EngrErics/LBTiny-FPGA/docs/diagram-links.md

Draw.IO
https://drive.google.com/file/d/1SJZEqH65o_Fi_vQxV7Hg5AI4URk4NXu5/view?usp=sharing

TinyTapeout Breakout PCB
https://github.com/TinyTapeout/breakout-pcb
https://github.com/psychogenic/tinytapeout-kicad-libs/tree/c213eb9e5d98a454f17367063bc4ec78d6119a49
