EngrErics/LBTiny-FPGA/src/lbtiny.xdc

## =========================================================================
## lbtiny.xdc
## Nexys A7-100T constraints for lbtiny_top (production integrated build).
## Target part: xc7a100tcsg324-1. Also works on -50T.
##
## Covers: clock, SW[15:0], BTNC, BTNU, LED[15:0], 7-seg,
##         Pmod JA (STM32 bus control + upper address),
##         Pmod JB (multiplexed address/data, bidirectional).
##
## SW[15]: CPU halt / viewer mutation enable.
##   UP   -> cpu_reset_n asserted, viewer BTNC/BTNU active.
##   DOWN -> CPU running, observation live, mutation blocked.
##
## LED[15]: CPU halted indicator (lit when SW15 up or STM32 holds RESET_n low).
## =========================================================================

## Clock: 100 MHz on-board oscillator
set_property -dict { PACKAGE_PIN E3 IOSTANDARD LVCMOS33 } [get_ports { CLK100MHZ }]
create_clock -add -name sys_clk_pin -period 10.00 -waveform {0 5} [get_ports { CLK100MHZ }]

## -------------------------------------------------------------------------
## Switches SW[15:0]
##   SW[11:0]  address select for viewer
##   SW[15]    CPU halt / mutation enable
##   SW[14:12] unused
## -------------------------------------------------------------------------
set_property -dict { PACKAGE_PIN J15 IOSTANDARD LVCMOS33 } [get_ports { SW[0]  }]
set_property -dict { PACKAGE_PIN L16 IOSTANDARD LVCMOS33 } [get_ports { SW[1]  }]
set_property -dict { PACKAGE_PIN M13 IOSTANDARD LVCMOS33 } [get_ports { SW[2]  }]
set_property -dict { PACKAGE_PIN R15 IOSTANDARD LVCMOS33 } [get_ports { SW[3]  }]
set_property -dict { PACKAGE_PIN R17 IOSTANDARD LVCMOS33 } [get_ports { SW[4]  }]
set_property -dict { PACKAGE_PIN T18 IOSTANDARD LVCMOS33 } [get_ports { SW[5]  }]
set_property -dict { PACKAGE_PIN U18 IOSTANDARD LVCMOS33 } [get_ports { SW[6]  }]
set_property -dict { PACKAGE_PIN R13 IOSTANDARD LVCMOS33 } [get_ports { SW[7]  }]
set_property -dict { PACKAGE_PIN T8  IOSTANDARD LVCMOS33 } [get_ports { SW[8]  }]
set_property -dict { PACKAGE_PIN U8  IOSTANDARD LVCMOS33 } [get_ports { SW[9]  }]
set_property -dict { PACKAGE_PIN R16 IOSTANDARD LVCMOS33 } [get_ports { SW[10] }]
set_property -dict { PACKAGE_PIN T13 IOSTANDARD LVCMOS33 } [get_ports { SW[11] }]
set_property -dict { PACKAGE_PIN H6  IOSTANDARD LVCMOS33 } [get_ports { SW[12] }]
set_property -dict { PACKAGE_PIN U12 IOSTANDARD LVCMOS33 } [get_ports { SW[13] }]
set_property -dict { PACKAGE_PIN U11 IOSTANDARD LVCMOS33 } [get_ports { SW[14] }]
set_property -dict { PACKAGE_PIN V10 IOSTANDARD LVCMOS33 } [get_ports { SW[15] }]

## Pushbuttons
set_property -dict { PACKAGE_PIN N17 IOSTANDARD LVCMOS33 } [get_ports { BTNC }]
set_property -dict { PACKAGE_PIN M18 IOSTANDARD LVCMOS33 } [get_ports { BTNU }]

## -------------------------------------------------------------------------
## LEDs LED[15:0]
##   LED[11:0]  viewed address (follows SW[11:0] live)
##   LED[12]    viewed address in ROM range (0x000-0xBFF)
##   LED[13]    viewed address in RAM range (0xC00-0xEFF)
##   LED[14]    fill_busy (BTNC operation in progress)
##   LED[15]    cpu_halted (CPU in reset; SW15 up or STM32 holds RESET_n)
## -------------------------------------------------------------------------
set_property -dict { PACKAGE_PIN H17 IOSTANDARD LVCMOS33 } [get_ports { LED[0]  }]
set_property -dict { PACKAGE_PIN K15 IOSTANDARD LVCMOS33 } [get_ports { LED[1]  }]
set_property -dict { PACKAGE_PIN J13 IOSTANDARD LVCMOS33 } [get_ports { LED[2]  }]
set_property -dict { PACKAGE_PIN N14 IOSTANDARD LVCMOS33 } [get_ports { LED[3]  }]
set_property -dict { PACKAGE_PIN R18 IOSTANDARD LVCMOS33 } [get_ports { LED[4]  }]
set_property -dict { PACKAGE_PIN V17 IOSTANDARD LVCMOS33 } [get_ports { LED[5]  }]
set_property -dict { PACKAGE_PIN U17 IOSTANDARD LVCMOS33 } [get_ports { LED[6]  }]
set_property -dict { PACKAGE_PIN U16 IOSTANDARD LVCMOS33 } [get_ports { LED[7]  }]
set_property -dict { PACKAGE_PIN V16 IOSTANDARD LVCMOS33 } [get_ports { LED[8]  }]
set_property -dict { PACKAGE_PIN T15 IOSTANDARD LVCMOS33 } [get_ports { LED[9]  }]
set_property -dict { PACKAGE_PIN U14 IOSTANDARD LVCMOS33 } [get_ports { LED[10] }]
set_property -dict { PACKAGE_PIN T16 IOSTANDARD LVCMOS33 } [get_ports { LED[11] }]
set_property -dict { PACKAGE_PIN V15 IOSTANDARD LVCMOS33 } [get_ports { LED[12] }]
set_property -dict { PACKAGE_PIN V14 IOSTANDARD LVCMOS33 } [get_ports { LED[13] }]
set_property -dict { PACKAGE_PIN V12 IOSTANDARD LVCMOS33 } [get_ports { LED[14] }]
set_property -dict { PACKAGE_PIN V11 IOSTANDARD LVCMOS33 } [get_ports { LED[15] }]

## Seven-segment display segments, active low
set_property -dict { PACKAGE_PIN T10 IOSTANDARD LVCMOS33 } [get_ports { CA }]
set_property -dict { PACKAGE_PIN R10 IOSTANDARD LVCMOS33 } [get_ports { CB }]
set_property -dict { PACKAGE_PIN K16 IOSTANDARD LVCMOS33 } [get_ports { CC }]
set_property -dict { PACKAGE_PIN K13 IOSTANDARD LVCMOS33 } [get_ports { CD }]
set_property -dict { PACKAGE_PIN P15 IOSTANDARD LVCMOS33 } [get_ports { CE }]
set_property -dict { PACKAGE_PIN T11 IOSTANDARD LVCMOS33 } [get_ports { CF }]
set_property -dict { PACKAGE_PIN L18 IOSTANDARD LVCMOS33 } [get_ports { CG }]
set_property -dict { PACKAGE_PIN H15 IOSTANDARD LVCMOS33 } [get_ports { DP }]

## Seven-segment anodes, active low
set_property -dict { PACKAGE_PIN J17 IOSTANDARD LVCMOS33 } [get_ports { AN[0] }]
set_property -dict { PACKAGE_PIN J18 IOSTANDARD LVCMOS33 } [get_ports { AN[1] }]
set_property -dict { PACKAGE_PIN T9  IOSTANDARD LVCMOS33 } [get_ports { AN[2] }]
set_property -dict { PACKAGE_PIN J14 IOSTANDARD LVCMOS33 } [get_ports { AN[3] }]
set_property -dict { PACKAGE_PIN P14 IOSTANDARD LVCMOS33 } [get_ports { AN[4] }]
set_property -dict { PACKAGE_PIN T14 IOSTANDARD LVCMOS33 } [get_ports { AN[5] }]
set_property -dict { PACKAGE_PIN K2  IOSTANDARD LVCMOS33 } [get_ports { AN[6] }]
set_property -dict { PACKAGE_PIN U13 IOSTANDARD LVCMOS33 } [get_ports { AN[7] }]

## -------------------------------------------------------------------------
## Pmod JA — upper address + bus control (STM32 supervisor inputs)
##   JA[1..4]   -> A[8..11]
##   JA[7]      -> ALE
##   JA[8]      -> RD_n
##   JA[9]      -> WR_n
##   JA[10]     -> RESET_n  (STM32 pulls low to take bus ownership)
##
## Pull strategy:
##   Internal IOB pulls ensure safe idle levels when the STM32 is not
##   connected.  External 10k resistors on the breadboard / reference board
##   override these (external wins — they are stronger than the ~50k IOB pull).
##
##   RESET_n  -> PULLUP   (float = high = not asserted, CPU runs normally)
##   RD_n     -> PULLUP   (float = high = not asserted, no spurious reads)
##   WR_n     -> PULLUP   (float = high = not asserted, no spurious writes)
##   ALE      -> PULLDOWN (float = low  = data phase,  no spurious latches)
##   A[11:8]  -> PULLDOWN (float = 0000 = harmless when ALE is low)
## -------------------------------------------------------------------------
set_property -dict { PACKAGE_PIN C17 IOSTANDARD LVCMOS33 PULLDOWN true } [get_ports { JA_AB[1]   }]  ;# JA1  - A[8]
set_property -dict { PACKAGE_PIN D18 IOSTANDARD LVCMOS33 PULLDOWN true } [get_ports { JA_AB[2]   }]  ;# JA2  - A[9]
set_property -dict { PACKAGE_PIN E18 IOSTANDARD LVCMOS33 PULLDOWN true } [get_ports { JA_AB[3]   }]  ;# JA3  - A[10]
set_property -dict { PACKAGE_PIN G17 IOSTANDARD LVCMOS33 PULLDOWN true } [get_ports { JA_AB[4]   }]  ;# JA4  - A[11]
set_property -dict { PACKAGE_PIN D17 IOSTANDARD LVCMOS33 PULLDOWN true } [get_ports { JA_CTL[7]  }]  ;# JA7  - ALE
set_property -dict { PACKAGE_PIN E17 IOSTANDARD LVCMOS33 PULLUP   true } [get_ports { JA_CTL[8]  }]  ;# JA8  - RD_n
set_property -dict { PACKAGE_PIN F18 IOSTANDARD LVCMOS33 PULLUP   true } [get_ports { JA_CTL[9]  }]  ;# JA9  - WR_n
set_property -dict { PACKAGE_PIN G18 IOSTANDARD LVCMOS33 PULLUP   true } [get_ports { JA_CTL[10] }]  ;# JA10 - RESET_n

## -------------------------------------------------------------------------
## Pmod JB — multiplexed address/data bus (bidirectional)
##   JB[1..4]   -> AD[0..3]
##   JB[7..10]  -> AD[4..7]
## No internal pulls — bus is actively driven by whoever owns it.
## -------------------------------------------------------------------------
set_property -dict { PACKAGE_PIN D14 IOSTANDARD LVCMOS33 } [get_ports { JB_AD_LO[1]  }]  ;# JB1  - AD[0]
set_property -dict { PACKAGE_PIN F16 IOSTANDARD LVCMOS33 } [get_ports { JB_AD_LO[2]  }]  ;# JB2  - AD[1]
set_property -dict { PACKAGE_PIN G16 IOSTANDARD LVCMOS33 } [get_ports { JB_AD_LO[3]  }]  ;# JB3  - AD[2]
set_property -dict { PACKAGE_PIN H14 IOSTANDARD LVCMOS33 } [get_ports { JB_AD_LO[4]  }]  ;# JB4  - AD[3]
set_property -dict { PACKAGE_PIN E16 IOSTANDARD LVCMOS33 } [get_ports { JB_AD_HI[7]  }]  ;# JB7  - AD[4]
set_property -dict { PACKAGE_PIN F13 IOSTANDARD LVCMOS33 } [get_ports { JB_AD_HI[8]  }]  ;# JB8  - AD[5]
set_property -dict { PACKAGE_PIN G13 IOSTANDARD LVCMOS33 } [get_ports { JB_AD_HI[9]  }]  ;# JB9  - AD[6]
set_property -dict { PACKAGE_PIN H16 IOSTANDARD LVCMOS33 } [get_ports { JB_AD_HI[10] }]  ;# JB10 - AD[7]

## -------------------------------------------------------------------------
## Configuration / bitstream options
## -------------------------------------------------------------------------
set_property CFGBVS VCCO        [current_design]
set_property CONFIG_VOLTAGE 3.3 [current_design]

## QSPI flash boot support (for persistent programming via program_bitstream.bat -persist)
set_property BITSTREAM.CONFIG.SPI_BUSWIDTH 4 [current_design]
set_property CONFIG_MODE SPIx4               [current_design]
