EngrErics/LBTiny-FPGA/(commit log)

2026-05-17 fixed rom ram not using bram, added memviewer to physically select addresses and see the contents. test write and clear working.
    [lbtiny_bus_slave.v, lbtiny_mem_viewer.xdc]
2026-05-17 peek memory is no using the bram dual port, this lets us watch memory addresses on the 7seg display while the cpu is reading and writing to mem. The bringup is a test bus master that writes to memory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
    [lbtiny.xdc, lbtiny_cpu.v, lbtiny_mem.v, lbtiny_top.v, lbtiny_viewer.v]
2026-05-17 fixed the build and program scripts
    [lbtiny_viewer.v]
2026-05-17 updated top to fix, basically the mock cpu was not really connected
    [lbtiny_top.v]
2026-05-17 I think the reset sw was preventing the write fsm
    [lbtiny_top.v]
2026-05-17 This needs testing. Added pullup in constraints to the reset line and finished connections to pmod for the supervisor in the lbtiny_top.v
    [lbtiny.xdc, lbtiny_top.v]
2026-05-17 had to fix top, reset had been taken over by the pullup and not allowing the internal mem viewer write functionality to work. hopefully this fixes it now. we had to add a bit of logic on the reset ha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
    [lbtiny_top.v]
2026-05-23 updated scripts to support persistent flash configuration, need to switch jumper on board
